jlaustill/ovgt/docs/holset/hx35/compressor-housings.md

# HX35 / H1C Compressor Housings — Part Number Reference

**Scope:** every genuine Holset part number catalogued as a *compressor housing* for the
**H1C / WH1C / HX35 / HX35W / HX35G** family. Compiled 2026-09-12.

Method, sourcing tiers and the `H`-suffix authenticity rule are identical to
[`turbine-housings.md`](turbine-housings.md) — read that first. Source data is the
archived cross-reference at [`../jhdiesel-full-catalog.tsv`](../jhdiesel-full-catalog.tsv).

## ⭐ The wastegate-tab rule (answers the current requirement)

**The wheel generation determines where the wastegate canister mounts** — and therefore
whether the compressor cover carries actuator tabs at all:

| Generation | Compressor wheel | Application | Wastegate canister mounts on | Cover has tabs? |
|---|---|---|---|---|
| **8-blade** | **56 / 82–83 mm** | '95–98 12v (manual) | **the TURBINE housing** | ✅ **NO TABS** |
| **7-blade** | **54 / 77–78 mm** | '99–02 24v (manual) | **the COMPRESSOR housing** | ❌ has tabs |

> *"You can normally tell them apart because the wastegate canister is mounted on the
> turbine housing, whereas the 7-blade's wastegate canister mounts on the compressor
> housing."* · *"When selecting a donor turbo for a turbine housing, make sure the
> actuator does not attach to the compressor cover."*

**So the tab-free cover you want is the 8-blade / 56 mm one** — the '95–98 12v generation.
This also explains the original problem: the core on hand, **`3592766`, is the 7-blade
54 mm** (`docs/holset-turbos.md:416`), i.e. the generation whose gate is *designed* to bolt
to the compressor cover. The spring gate fouling the cover is a generational mismatch, not
a defect — the same root cause as the turbine-housing clearance issue.

⚠️ **The wheel and cover must change together.** 7-blade is 54×78, 8-blade is 56×83;
they are **not interchangeable between each other's housings**. A 56 mm cover requires the
56 mm 8-blade wheel. The on-hand core's 54 mm wheel will not run in it.

⚠️ **Flow figures conflict — do not plan on them yet.** One forum source claims the
8-blade flows **52 lb/min** and the 7-blade **60 lb/min**, i.e. the *larger* wheel flowing
*less*. That is backwards on its face and contradicts `docs/holset-turbos.md:40–41`
(8-blade 56/82, 7-blade 54/76.5). Against the ~45–50 lb/min target this matters, so treat
both numbers as unverified until a compressor map is found.

**Aftermarket alternative:** matched housing + wheel sets exist and sidestep the whole
question — Gillett `CH-10` (60 mm 7-blade upgrade housing **and** wheel), and the Fenley
60 mm billet + matched cover already noted at `docs/holset-turbos.md:97`. Buying the pair
guarantees the contour matches the wheel.

## ✅ DECISION 2026-09-12: keep the 54 mm wheel, cut the tabs off the existing cover

**Staying on the 7-blade 54×78 compressor already on the core (`3592766`). The wastegate
tabs get cut off that cover rather than buying a tab-free 56 mm cover and wheel.**

Rationale: the 54 mm is close enough to generate a real operating dataset, and the truck
already carries 10 Hz CE / BPR / boost telemetry. The 52 vs 60 lb/min conflict below cannot
be settled from the available sources — but it *can* be settled from logged map coverage
against the ~45–50 lb/min target. Spending ~$160 first would be buying on numbers this
document already flags as untrustworthy. Consistent with the *"stock-spec baseline, then
iterate"* test plan in `docs/holset-turbos.md`.

**This closes the 56 mm question for now.** It is deferred, not abandoned — the swap is a
cover-and-wheel pair whenever data justifies it, and a cut-up 54 mm cover costs nothing to
walk away from at that point.

### Cutting the tabs — cautions

1. **Confirm what is actually fouling first.** The complaint was the spring gate "running
   into the compressor cover." If it contacts the **tabs**, cutting fixes it; if it contacts
   the **scroll body**, cutting achieves nothing. Mock it up and mark the contact point
   before cutting.
2. **Wall thickness is the one real hazard.** The boss may blend into the scroll wall rather
   than stand proud of it. Cutting through breaches the pressure boundary — a boost leak on
   the HP stage, which would then get chased as a phantom fault. **Probe the thickness
   first; leave the stubs proud rather than flush if unsure.** Flush is cosmetic, intact is
   functional.
3. **Cover off the turbo, cut on the bench, wash out completely.** Aluminium swarf into the
   compressor wheel ends the wheel.
4. Cast aluminium — cutoff wheel, die grinder or bandsaw all work. Irreversible, but this
   is the common cover and replacements are cheap.

### Still open regardless of this decision

Cutting tabs does **not** substitute for the turbine housing. A 12 cm² divided housing with
a **turbine-side** gate is still required — `3532214` (~$599) or the `3591217` casting
(~$120). See [`turbine-housings.md`](turbine-housings.md).

## Sourcing a 56 mm cover + wheel (surveyed 2026-09-12)

> ℹ️ Superseded by the decision above; retained because it documents the tab-free options
> and their verification, which matter again if the 56 mm swap is revisited.

The on-hand core is 7-blade 54 mm, so **both the wheel and the cover must be bought** —
they are not separable decisions. Prices are a snapshot; eBay listings move.

| Option | Price | What it gets | Notes |
|---|---|---|---|
| **Wheel only** | **$45–50** | 56×83 8-blade factory wheel, balanced | Seller *jackassturbo* states it plainly: *"Fits 1996–1998 Dodge Ram 5.9 Cummins HX35… **Does not fit** factory HX35 turbo on 1999–2002 manual"* — independent confirmation of the generation rule above. Still needs a tab-free cover |
| **Cover + wheel** ⭐ | **$159.99** | Compressor housing **and** 56 mm 8-blade wheel | *"Compressor housing with 4" inlet and vband discharge flange for HX35/40 bearing housings and includes 8 blade cast aluminum 56mm inducer compressor wheel."* Fort Collins, CO. **Tab-free — visually confirmed** (see below) |
| ❌ **Complete '96–98 turbo** | ~$312–331 | **Does NOT deliver a tab-free cover** | See the correction below — photos show a **compressor-mounted** actuator bracket despite the '96–98 listing title |
| ❌ "Supercore" listings | $199–249 | — | The ones found are **52 mm**, not 56 mm. Wrong wheel. Do not buy on the word "supercore" alone |

### ❌ Correction: the ~$312 complete turbo does not solve the tab problem

Initially flagged as the value play on the reasoning that a '96–98 unit would carry the
turbine-side gate. **Photos of the actual listing show otherwise**
([ebay.com/itm/357345678203](https://www.ebay.com/itm/357345678203), $312.25, seller
`yikaparts`, ships from CN; cites PNs `3539373` / `3538881`, both genuine
`TURBOCHARGER,HX35 WASTEGA` entries in the catalog):

The wastegate canister is carried on a **long diagonal bracket bolted to the compressor
housing**, with the rod running down to the wastegate arm on the turbine housing. That is
the compressor-cover-mounted arrangement — precisely what this requirement exists to avoid.
The T3 inlet gasket in the photos *is* correctly divided, but the actuator mounting is wrong
for this build.

⚠️ **Generalise from this:** the 8-blade → turbine-mounted-canister rule describes
**genuine Holset** production. An aftermarket reproduction can mix configurations regardless
of the model years in its title, and stock photos may not depict the item shipped. **The
generation rule does not transfer to repro units** — for those, only a photo of the actual
part settles it.

### ✅ Tab-free confirmed by photo, not by marketing copy

Listing photos of the $159.99 cover were downloaded and inspected directly. **The housing
carries no wastegate actuator tabs, bosses or drilled ears anywhere on the scroll or the
outer face.** Both faces are visible across the photo set. This is the first item in this
whole reference confirmed by an actual image rather than seller text.

Also visible: a **V-band discharge flange**, a large **4" inlet**, and a cast/machined data
pad reading `P/N:4761339  S/N:1161530182212`.

⚠️ **`4761339` is not a Holset number.** It is absent from the cross-reference, and more
tellingly the catalog contains **no `476xxxx` prefix at all** (its prefixes run 28, 30–32,
35–40, 43, 48–49, 52–53). Unlike `3591217`, which sat inside a dense Holset block, this
number falls outside the numbering space entirely — so this is an **aftermarket housing**.
For this purpose that is not a defect: aftermarket performance covers are *why* it has no
tabs. But it is not a genuine Holset casting and should not be recorded as one.

⚠️ **Two things to check before buying this specific item:**
1. **Blade count.** The listing says 8-blade; the wheel in the photo appears to show more
   than eight. The top-down angle and shadows make it unreliable to count — ask the seller
   for a straight-on shot and count them.
2. **Casting damage.** A close-up of the bearing-housing register shows a **gouge / chipped
   area on the machined outer step**. It may be cosmetic, but that face locates and seals
   against the bearing housing. Ask about it.

⚠️ **Plumbing changes.** A 4" inlet and V-band discharge is not the stock arrangement. In
the compound layout the HP compressor inlet is fed by the S472 LP discharge, so a large
inlet is not itself a problem — but the connections will need to be made to suit.

## Part numbers

`?` means *not yet sourced*, never *not applicable*. Per-PN compressor-housing specs are as
absent from the public web as the turbine-housing ones — the catalog gives model attribution
only, and vendors list these as bare "GENUINE HOLSET COMPRESSOR HOUSING" with no wheel size
or tab information.

| PN | Model | Inducer | Exducer | WG tabs | Inlet | Outlet | Verified | raw_notes |
|---|---|---|---|---|---|---|---|---|
| 3532465 | HX35 | ? | ? | ? | ? | ? | catalog only | `HOUSING,COMPRESSOR,HX35` |
| 3532467 | HX35 | ? | ? | ? | ? | ? | catalog only | `HOUSING,COMPRESSOR,HX35` |
| 3536495 | HX35 | ? | ? | ? | ? | ? | catalog only | `HOUSING,COMPRESSOR,HX35` |
| 3536502 | HX35 | ? | ? | ? | ? | ? | catalog only | `HOUSING,COMPRESSOR,HX35` |
| 3537726 | HX35 | ? | ? | ? | ? | ? | catalog only | `HOUSING,COMPRESSOR,HX35` |
| 3537732 | HX35 | ? | ? | ? | ? | ? | catalog only | `HOUSING,COMPRESSOR,HX35` |
| 3538769 | HX35 | ? | ? | ? | ? | ? | catalog only | `HOUSING,COMPRESSOR.HX35` |
| 3590646 | HX35W | ? | ? | ? | ? | ? | catalog only | `HOUSING,COMPRESSOR.HX35W.ASSY` |
| 3591005 | HX35W | ? | ? | ? | ? | ? | catalog only | `HOUSING,COMPRESSOR,HX35W,ASSY` |
| 3591006 | HX35W | ? | ? | ? | ? | ? | catalog only | `HOUSING,COMPRESSOR.HX35W.ASSY` |
| 3591008 | HX35W | ? | ? | ? | ? | ? | catalog only | `HOUSING,COMPRESSOR.HX35W.ASSY` |
| 3591012 | HX35G | ? | ? | ? | ? | ? | catalog only ⚠️ | `HOUSING,COMPRESSOR.HX35G.ASSY`. ⚠️ **Gas/CNG variant** — `G` is the natural-gas application (catalog lists `TURBOCHARGER,HX35GAS`); water-cooled, billet 7-blade. Wheel family not established for the diesel build |
| 3591014 | HX35W | ? | ? | ? | ? | ? | catalog only | `HOUSING,COMPRESSOR.HX35W.ASSY` |
| 3592355 | HX35 | ? | ? | ? | ? | ? | catalog only | `HOUSING,COMPRESSOR.HX35` |
| 3595195 | HX35 | ? | ? | ? | ? | ? | catalog only | `HOUSING,COMPRESSOR,HX35` |
| 3595896 | HX35 | ? | ? | ? | ? | ? | catalog only | `HOUSING,COMPRESSOR,HX35` |
| 3596776 | HX35W | ? | ? | ? | ? | ? | catalog only | `HOUSING,COMPRESSOR,HX35W,ASSY` |
| 3597306 | HX35 | ? | ? | ? | ? | ? | catalog only | `HOUSING,COMPRESSOR,HX35` |
| 3598643 | HX35 | ? | ? | ? | ? | ? | catalog only | `HOUSING,COMPRESSOR,HX35,ASSY` |
| 3599319 | HX35W | ? | ? | ? | ? | ? | catalog only | `HOUSING,COMPRESSOR,HX35W,ASSY` |
| 3599984 | HX35 | ? | ? | ? | ? | ? | catalog only | `HOUSING,COMPRESSOR,HX35` |
| 4036101 | HX35W | ? | ? | ? | ? | ? | catalog only | `HOUSING,COMPRESSOR,HX35W,ASSY` |
| 4036492 | HX35 | ? | ? | ? | ? | ? | catalog only | `HOUSING,COMPRESSOR,HX35` |
| 4036745 | HX35W | ? | ? | ? | ? | ? | catalog only | `HOUSING,COMPRESSOR,HX35W,ASSY` |
| 4037109 | HX35 | ? | ? | ? | ? | ? | catalog only | `HOUSING,COMPRESSOR,HX35` |
| 4037836 | HX35 | ? | ? | ? | ? | ? | catalog only | `HOUSING,COMPRESSOR.HX35` |
| 4038469 | HX35W | ? | ? | ? | ? | ? | **vendor-listed** | `HOUSING,COMPRESSOR,HX35W,ASSY`. Denco: *"BRAND NEW GENUINE HOLSET COMPRESSOR HOUSING"*, HX35, 5.0 kg, A$356.36. No wheel size or tab detail given |
| 4040185 | HX35W | ? | ? | ? | ? | ? | catalog only | `HOUSING,COMPRESSOR,HX35W,ASSY` |
| 4044030 | HX35 | ? | ? | ? | ? | ? | catalog only | `HOUSING,COMPRESSOR.HX35` |

## Caveats

**The catalog is not exhaustive** — same as the turbine-housing list. `3591005`/`3591006`/
`3591008`/`3591014` are all `HOUSING,COMPRESSOR.HX35W.ASSY` with no way to tell them apart
from the catalog alone, and the bare-casting vs `.ASSY` distinction (housing alone vs
housing + fitted hardware) is unresolved here exactly as it is there.

**Tabs are the thing to verify, and no vendor states it.** Not one listing found mentions
actuator bracket bosses either way. Until a vendor or a measured photo confirms it, the
only reliable signal is the **generation** (8-blade '95–98 = no tabs) rather than the part
number. Ask for a photo of the cover's outer face.

## Sources

- Archived cross-reference: [`../jhdiesel-full-catalog.tsv`](../jhdiesel-full-catalog.tsv)
- [Mopar1973Man — Holset turbo specs](https://mopar1973man.com/cummins/articles.html/general-cummins/84_engine/89_air-exhaust/holset-turbo-specs-r156/) — blade count / canister location rule
- [Denco — 4038469 compressor housing](https://www.dencodiesel.com/products/4038469-holset-compressor-housing-hx35)
- [Gillett — CH-10 60 mm 7-blade upgrade housing + wheel](https://www.gillettdiesel.com/shop/Holset-HX-Upgrade-Compressor-Housing--and--Wheel-60mm--7-blade-CH-10)
- Sibling docs: [`turbine-housings.md`](turbine-housings.md) · [`chra-cores.md`](chra-cores.md) · parent `docs/holset-turbos.md`
