jlaustill/ovgt/src/sensors/j1939.cpp

#include <Arduino.h>
#include <FlexCAN_T4.h>
#include "j1939.h"
#include "AppData.h"
#include "j1939Decode.h"
#include "j1939Health.h"
#include "j1939Encode.h"
#include "systemHealth.h"
#include <J1939McuHealth.h>
#include "mcuHealthFrame.h"

// CAN2 = Teensy 4.1 pins 0 (RX) / 1 (TX). J1939 @ 250 kbps, 29-bit extended IDs.
static FlexCAN_T4<CAN2, RX_SIZE_256, TX_SIZE_16> Can1939;

static const uint8_t  SA              = 0x01;
static const uint32_t PGN_AMB         = 65270; // AMB — SPN 102 (byte 2, boost), SPN 173 (bytes 6-7, EGT)
static const uint32_t PGN_OIL_TEMP    = 65262; // SPN 175 (bytes 3-4) + SPN 176 (bytes 5-6) — Engine Oil Temperature
static const uint32_t PGN_FLUID_PRESS = 65263; // SPN 94 (byte 1) fuel, SPN 100 (byte 4) oil pressure
static const uint32_t PGN_EEC2 = 61443; // EEC2 — SPN 91 throttle, SPN 92 load
static const uint32_t PGN_ETC1 = 61442; // ETC1 — SPN 573 TCC lockup, 191/161/522

// J1939 RX-decode targets (received from engine/trans; distinct from OVGT's own TX).
static const uint32_t PGN_EEC1     = 61444;
static const uint32_t PGN_IC1      = 65270; // engine SA 0x00 (distinct from OVGT's own TX)
static const uint32_t PGN_AMB65269 = 65269;
static const uint32_t PGN_VEP1     = 65271;
static const uint32_t PGN_ET1      = 65262;
static const uint32_t PGN_EFLP1    = 65263;
static const uint32_t PGN_ETC2     = 61445;

static const uint8_t SA_ENGINE = 0x00;
static const uint8_t SA_TRANS  = 0x03;

// Unknown-PGN discovery inventory (ISR-updated, main-loop-read).
struct UnknownPgn {
    uint32_t pgn;
    uint8_t  sa;
    uint32_t count;
    uint32_t firstMs;
    uint32_t lastMs;
    uint8_t  last[8];
};
static const uint8_t UNKNOWN_MAX = 32;
static volatile UnknownPgn unknownTable[UNKNOWN_MAX];
static volatile uint8_t unknownUsed = 0;
static volatile uint32_t unknownDropped = 0;

static void tallyUnknown(uint32_t pgn, uint8_t sa, const uint8_t *buf, uint32_t now) {
    for (uint8_t i = 0; i < unknownUsed; i++) {
        if (unknownTable[i].pgn == pgn && unknownTable[i].sa == sa) {
            unknownTable[i].count++;
            unknownTable[i].lastMs = now;
            for (uint8_t b = 0; b < 8; b++) unknownTable[i].last[b] = buf[b];
            return;
        }
    }
    if (unknownUsed >= UNKNOWN_MAX) { unknownDropped++; return; }
    uint8_t i = unknownUsed++;
    unknownTable[i].pgn = pgn; unknownTable[i].sa = sa;
    unknownTable[i].count = 1; unknownTable[i].firstMs = now; unknownTable[i].lastMs = now;
    for (uint8_t b = 0; b < 8; b++) unknownTable[i].last[b] = buf[b];
}

// Standard turbo/intake PGNs (each carries our signal in bytes 1-2, turbo 2-4
// siblings left 0xFF = not available). See docs/j1939-spn-mapping.md.
static const uint32_t PGN_ENGINE_INFO     = 65170; // SPN 1209 exhaust gas (turbine inlet) pressure, bytes 2-3
static const uint32_t PGN_INTAKE_MANIFOLD = 65190; // SPN 1127 turbo 1 boost pressure, bytes 1-2
static const uint32_t PGN_TURBO_INFO_2    = 65178; // SPN 1172 compressor intake temp, bytes 1-2
static const uint32_t PGN_TURBO_INFO_3    = 65177; // SPN 1176 compressor intake pressure, bytes 1-2
static const uint32_t PGN_TURBO_INFO_4    = 65176; // SPN 1180 turbine intake temp, bytes 1-2
static const uint32_t PGN_TURBO_INFO_6    = 64979; // SPN 2629 compressor outlet temp, bytes 1-2

static uint32_t lastTx100ms = 0;
static uint32_t lastTx500ms = 0;
static uint32_t lastTx1000ms = 0;

// Write a 2-byte little-endian J1939 field at buf[pos] (0-based).
static void put16(uint8_t *buf, uint8_t pos, uint16_t value) {
    buf[pos] = value & 0xFF;
    buf[pos + 1] = value >> 8;
}

static void j1939Sniff(const CAN_message_t &msg) {
    uint32_t pgn = pgnFromCanId(msg.id);
    uint8_t  sa  = saFromCanId(msg.id);
    uint32_t now = millis();

    if (sa == SA_ENGINE) {
        switch (pgn) {
            case PGN_EEC1:
                appData.engineRpm = decodeEngineRpm(msg.buf);
                appData.engineRpmRaw = j1939RawStatus2Byte((uint16_t)msg.buf[3] | ((uint16_t)msg.buf[4] << 8));
                appData.driverDemandTorquePct = decodeDriverDemandTorquePct(msg.buf);
                appData.actualTorquePct = decodeActualTorquePct(msg.buf);
                appData.torqueRaw = j1939RawStatus1Byte(msg.buf[2]);
                appData.lastEec1RxMs = now;
                if (appData.engineOnlineAtMs == 0) appData.engineOnlineAtMs = now;
                return;
            case PGN_EEC2:
                appData.acceleratorPedalPercent = decodeAcceleratorPedalPercent(msg.buf);
                appData.engineLoadPercent = decodeEngineLoadPercent(msg.buf);
                appData.lastEec2RxMs = now;
                if (appData.engineOnlineAtMs == 0) appData.engineOnlineAtMs = now;
                return;
            case PGN_IC1:
                appData.intakeAirTempC = decodeIntakeAirTempC(msg.buf);
                appData.intakeAirRaw = j1939RawStatus1Byte(msg.buf[2]);
                appData.j1939BoostKpa = decodeBoostKpa(msg.buf);
                appData.boostRaw = j1939RawStatus1Byte(msg.buf[1]);
                appData.lastIc1RxMs = now;
                return;
            case PGN_AMB65269:
                appData.preTurboKpa = decodePreTurboKpa(msg.buf);
                appData.preTurboRaw = j1939RawStatus1Byte(msg.buf[0]);
                appData.lastAmbRxMs = now;
                return;
            case PGN_VEP1:
                appData.systemVoltage = decodeSystemVoltage(msg.buf);
                appData.systemVoltageRaw = j1939RawStatus2Byte((uint16_t)msg.buf[4] | ((uint16_t)msg.buf[5] << 8));
                appData.lastVep1RxMs = now;
                return;
            case PGN_ET1:
                appData.coolantTempC = decodeCoolantTempC(msg.buf);
                appData.coolantRaw = j1939RawStatus1Byte(msg.buf[0]);
                appData.engineOilTempC = decodeOilTempC(msg.buf);
                appData.oilTempRaw = j1939RawStatus2Byte((uint16_t)msg.buf[2] | ((uint16_t)msg.buf[3] << 8));
                appData.lastEt1RxMs = now;
                return;
            case PGN_EFLP1:
                appData.oilPressureKpaJ1939 = decodeOilPressureKpa(msg.buf);
                appData.oilPressRaw = j1939RawStatus1Byte(msg.buf[3]);
                appData.lastEflRxMs = now;
                return;
        }
    } else if (sa == SA_TRANS) {
        switch (pgn) {
            case PGN_ETC1:
                appData.torqueConverterLockupStatus = decodeTorqueConverterLockup(msg.buf);
                appData.outputShaftRpm = decodeOutputShaftRpm(msg.buf);
                appData.outputShaftRaw = j1939RawStatus2Byte((uint16_t)msg.buf[1] | ((uint16_t)msg.buf[2] << 8));
                appData.inputShaftRpm = decodeInputShaftRpm(msg.buf);
                appData.inputShaftRaw = j1939RawStatus2Byte((uint16_t)msg.buf[5] | ((uint16_t)msg.buf[6] << 8));
                appData.clutchSlipPct = decodeClutchSlipPct(msg.buf);
                appData.clutchSlipRaw = j1939RawStatus1Byte(msg.buf[3]);
                appData.lastEtc1RxMs = now;
                if (appData.transOnlineAtMs == 0) appData.transOnlineAtMs = now;
                return;
            case PGN_ETC2:
                appData.selectedGear = decodeSelectedGear(msg.buf);
                appData.selectedGearRaw = j1939RawStatus1Byte(msg.buf[0]);
                appData.currentGear = decodeCurrentGear(msg.buf);
                appData.currentGearRaw = j1939RawStatus1Byte(msg.buf[3]);
                appData.gearRatioMilli = decodeGearRatioMilli(msg.buf);
                appData.gearRatioRaw = j1939RawStatus2Byte((uint16_t)msg.buf[1] | ((uint16_t)msg.buf[2] << 8));
                appData.lastEtc2RxMs = now;
                if (appData.transOnlineAtMs == 0) appData.transOnlineAtMs = now;
                return;
        }
    }
    // Undecoded frame from any SA (skip our own SA 0x01 transmissions).
    if (sa != SA) tallyUnknown(pgn, sa, msg.buf, now);
}

void J1939::Initialize() {
    Can1939.begin();
    Can1939.setBaudRate(250 * 1000);
    Can1939.setMaxMB(16);
    // Non-FIFO default: MB0-7 RX_EMPTY, MB8-15 TX_INACTIVE
    Can1939.enableMBInterrupts();   // RX full + TX done interrupts on all MBs
    Can1939.onReceive(j1939Sniff);
    Serial.println("J1939 (CAN2 @ 250kbps) initialized");
}

static void sendPgn(uint32_t pgn, const uint8_t* data) {
    CAN_message_t msg;
    msg.flags.extended = 1;
    msg.id = (6UL << 26) | (pgn << 8) | SA;
    msg.len = 8;
    memcpy(msg.buf, data, 8);
    Can1939.write(msg);
}

static void transmit100ms() {
    uint8_t buf[8];

    // AMB — PGN 65270
    // SPN 102 (byte 2): intake manifold pressure, 2 kPa/bit
    // SPN 173 (bytes 6-7): EGT, 0.03125 deg C/bit, offset -273
    memset(buf, 0xFF, 8);
    buf[1] = (uint8_t)((appData.compressorOutputPressureHpaa - appData.compressorInputPressureHpaa) / 10 / 2);
    uint16_t egtRaw = (uint16_t)((appData.turbineInletTempC + 273) * 32);
    buf[5] = egtRaw & 0xFF;
    buf[6] = egtRaw >> 8;
    sendPgn(PGN_AMB, buf);

    // Oil Temp — PGN 65262
    // SPN 175 (bytes 3-4): Engine Oil Temp 1, 0.03125 deg C/bit, offset -273
    // SPN 176 (bytes 5-6): Turbocharger Oil Temp, same encoding
    memset(buf, 0xFF, 8);
    uint16_t oilTmpRaw = (uint16_t)((appData.oilTempC + 273) * 32);
    buf[2] = oilTmpRaw & 0xFF;
    buf[3] = oilTmpRaw >> 8;
    buf[4] = oilTmpRaw & 0xFF;
    buf[5] = oilTmpRaw >> 8;
    sendPgn(PGN_OIL_TEMP, buf);

    // Engine Information — PGN 65170 (standard rate 100 ms)
    // SPN 1209 (bytes 2-3): exhaust gas / turbine inlet (drive) pressure
    memset(buf, 0xFF, 8);
    put16(buf, 1, j1939EncodeTurboPressureRaw((float)appData.turbineInputPressureHpa));
    sendPgn(PGN_ENGINE_INFO, buf);
}

static void transmit500ms() {
    uint8_t buf[8];

    // Fluid pressures — PGN 65263
    // SPN 94 (byte 1): fuel delivery pressure, 4 kPa/bit
    // SPN 100 (byte 4): engine oil pressure, 4 kPa/bit
    memset(buf, 0xFF, 8);
    buf[0] = (uint8_t)(appData.liftPumpPressureHpa / 10 / 4);
    buf[3] = (uint8_t)(appData.oilPressureHpa / 10 / 4);
    sendPgn(PGN_FLUID_PRESS, buf);

    // Intake Manifold Information 1 — PGN 65190 (standard rate 500 ms)
    // SPN 1127 (bytes 1-2): turbo 1 boost pressure, 0.125 kPa/bit
    memset(buf, 0xFF, 8);
    float boostHpa = (float)appData.compressorOutputPressureHpaa
                   - (float)appData.compressorInputPressureHpaa;
    put16(buf, 0, j1939EncodeBoostRaw(boostHpa));
    sendPgn(PGN_INTAKE_MANIFOLD, buf);
}

static void transmit1000ms() {
    uint8_t buf[8];

    // Turbocharger Information 4 — PGN 65176: SPN 1180 turbine intake temp
    memset(buf, 0xFF, 8);
    put16(buf, 0, j1939EncodeTemperatureRaw((float)appData.turbineInletTempC));
    sendPgn(PGN_TURBO_INFO_4, buf);

    // Turbocharger Information 2 — PGN 65178: SPN 1172 compressor intake temp (CIT)
    memset(buf, 0xFF, 8);
    put16(buf, 0, j1939EncodeTemperatureRaw((float)appData.compressorInputTempC));
    sendPgn(PGN_TURBO_INFO_2, buf);

    // Turbocharger Information 6 — PGN 64979: SPN 2629 compressor outlet temp (COT)
    memset(buf, 0xFF, 8);
    put16(buf, 0, j1939EncodeTemperatureRaw((float)appData.compressorOutputTempC));
    sendPgn(PGN_TURBO_INFO_6, buf);

    // Turbocharger Information 3 — PGN 65177: SPN 1176 compressor intake pressure (CIP)
    memset(buf, 0xFF, 8);
    put16(buf, 0, j1939EncodeTurboPressureRaw((float)appData.compressorInputPressureHpaa));
    sendPgn(PGN_TURBO_INFO_3, buf);

    // MCU health — PGN 0xFFDC (Proprietary B, broadcast). Controller die temp +
    // reset cause + boot count + uptime, so a listener collects one record per MCU
    // by source address. Payload encoding lives in jlaustill/J1939 (McuHealth).
    McuHealth health = buildMcuHealth(tempmonGetTemp(),
                                      SystemHealth_resetCauseCode(),
                                      SystemHealth_bootCount(),
                                      millis() / 60000UL);
    uint8_t healthBuf[8];
    J1939McuHealth_encode(&health, healthBuf);
    sendPgn(J1939McuHealth_PGN, healthBuf);
}

uint8_t J1939::unknownCount() { return unknownUsed; }
uint32_t J1939::unknownDroppedCount() { return unknownDropped; }

bool J1939::unknownAt(uint8_t i, uint32_t &pgn, uint8_t &sa, uint32_t &count,
                      uint32_t &firstMs, uint32_t &lastMs, uint8_t out8[8]) {
    if (i >= unknownUsed) return false;
    noInterrupts();
    pgn = unknownTable[i].pgn; sa = unknownTable[i].sa; count = unknownTable[i].count;
    firstMs = unknownTable[i].firstMs; lastMs = unknownTable[i].lastMs;
    for (uint8_t b = 0; b < 8; b++) out8[b] = unknownTable[i].last[b];
    interrupts();
    return true;
}

void J1939::Loop() {
    Can1939.events();
    uint32_t now = millis();
    if (now - lastTx100ms >= 100) {
        lastTx100ms = now;
        transmit100ms();
    }
    if (now - lastTx500ms >= 500) {
        lastTx500ms = now;
        transmit500ms();
    }
    if (now - lastTx1000ms >= 1000) {
        lastTx1000ms = now;
        transmit1000ms();
    }
}
