jlaustill/ovgt/(commit log)

2025-01-28 initial actuator code
2025-05-23 encapsulate lcd code and use a timer instead of millis
2025-05-23 Add README with hardware documentation and refactor actuator pin to be configurable
2025-05-23 Update README: Mark LCD as optional and correct CAN bus description
2025-06-02 Update README.md
    Adjust pins for I2C usage
2026-03-03 Remove ADS7606, MicroMod Teensy, and thermocouple references
    Simplify hardware scope to current build: Teensy 4.1, 2x CAN
    transceivers, FRAM, TIP120, and optional LCD. Removes unused
    Adafruit_BusIO and Adafruit_ADS1X15 dependencies.
2026-03-03 Add boost control loop design document
    Documents the architecture for ADS1115 sensor integration with
    closed-loop VGT vane control via pressure-to-position lookup table.
2026-03-03 Add BoostSensor module for ADS1115 pressure reading
2026-03-03 Add BoostController with tunable pressure-to-position lookup table
2026-03-03 Implement interpolation logic for pressure-to-position lookup table
2026-03-03 Simplify Actuator to read demanded position from AppData
2026-03-03 Wire BoostSensor and BoostController into main loop
2026-03-03 Update LCD to display boost pressure
2026-03-03 Move actuator CAN to CAN3 (pins 30/31) due to bad CAN2 transceiver
    Swapped actuator and J1939 CAN bus assignments. CAN2 transceiver
    (pins 0/1) is faulty — actuator now uses CAN3 on the working
    transceiver. README updated to match.
2026-03-03 Add actuator calibration sweep and raw position tracking
    - Add rawPosition field to AppData for unprocessed CAN feedback
    - Invert reported position mapping (vanes open = higher %)
    - Add CalibrateLoop() that sweeps PWM 0-255 logging CSV data
    - Remove per-message CAN serial spam, consolidate to 1s summary
    - Improve debug output with all telemetry on one line
    [AppData.h, ovgt.cpp]
2026-03-03 Add manual PWM control, vane calibration mapping, and 5V power good safety
    - Add serial command interface: type 0-247 for manual PWM, 'auto' for normal
    - Fix SetPosition to use correct vane calibration (PWM 7-201)
    - Add SetPWM method for direct actuator control during calibration
    - Read 5V PSU power good on pin 33: if PG fails, force vanes to 95% open
    - Update debug output with PG status and demanded position
    [ovgt.cpp, ovgt.h]
2026-03-04 Show raw actuator position, fix PG logic, tune lookup table
    - Remove fake reported position percentage, show raw CAN value instead
    - Fix PG pin read logic for active-low signal
    - Update first lookup table entry to 20% at 1000 hPa
    [ovgt.cpp]
2026-03-06 Add multi-channel ADS1115 round-robin and make appData a global
    Replace single-channel BoostSensor with AdcSensors that reads 4 channels
    (boost pressure, compressor input pressure, compressor input temp,
    turbine input pressure) via non-blocking single-shot conversions with
    DRDY interrupt. Make appData a global extern instead of passing pointers
    through every class.
    [AppData.h, adcSensors.cpp, adcSensors.h, ovgt.cpp, ovgt.h]
2026-03-14 Fix manual vane control and move debug output out of ISR
    - Move heavy debug work (I2C LCD + Serial prints) from IntervalTimer ISR
    to main loop via flag, fixing serial input being dropped
    - Manual mode now sets vane position (0-100%) instead of raw PWM
    - Keep sensors updating in manual mode so readings stay live
    - Add gauge boost, ambient pressure tracking, and boost ratio to debug output
    - Update boost controller to use gauge boost instead of absolute pressure
    [AppData.h, adcSensors.cpp, ovgt.cpp, ovgt.h]
2026-04-03 Switch to CAN actuator control, PSI lookup table, and simplified debug
    Replace LCD display with CAN-based vane position commands (0x4EA/0x4EB),
    convert boost lookup table from hPa to PSI to match dashboard display,
    and streamline serial debug to four key fields for road tuning.
    - CAN actuator: 20ms IntervalTimer, position mapping 0-250, feedback 0-1000
    - PSI lookup table with float interpolation (0→30%, 2→40%, 7.3→50%, 53.5→68%)
    - Correct TIP sensor to 100 PSIG (was 150), update scaling factor
    - Add DWT cycle counting and 10ms loop rate limiting
    - Remove LiquidCrystal_I2C dependency and lcdDisplay files
    - Include pid_bench.cpp for standalone PID testing (excluded from build)
    Co-Aut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
    [AppData.h, adcSensors.cpp, ovgt.cpp, ovgt.h, pid_bench.cpp]
2026-04-04 Add 860 SPS EMA filtering, TIP zero calibration, and dedicated ADC timer
    Bump ADS1115 to 860 SPS with exponential moving average (alpha=0.01) to
    eliminate sensor noise that caused false boost/BPR readings at rest.
    Add per-session TIP zero voltage calibration with runtime floor tracking
    to handle sensor tolerance below the nominal 0.5V zero point. Decouple
    ADC sampling from the 10ms control loop onto its own 1.2ms timer.
    [AppData.h, adcSensors.cpp, adcSensors.h, ovgt.cpp]
2026-04-29 Add MAX31856 thermocouple sensors, update pin assignments, and document hardware
    - Add COT, CIT, TIT, TOT sensor drivers (MAX31856 #1-4)
    - Update titSensor to new pin assignment (CS=5, DRDY=3, FLT=4)
    - Add compressorOutputTempC and turbineOutletTempC to AppData
    - Document all sensor channels and pin assignments in README
    - Fix FRAM CS pin (32→10) and add FRAM HOLD/WP pins
    - Add second ADS1115 (0x49) pin and channel documentation
    - Update boost controller pressure map
    [AppData.h, citSensor.cpp, j1939.cpp, j1939.h, ovgt.cpp]
2026-04-29 Add FRAM support and fix SPI bus CS pin initialization
    - Add Adafruit FRAM SPI library and fram.cpp/h driver
    - Drive all SPI CS pins HIGH at startup to prevent bus contention
    - This fixed FRAM write failures caused by floating MAX31856 CS pins
    [fram.cpp, ovgt.cpp]
2026-04-30 Add J1939 TX for EGT/oil temp/fuel pressure and enable boost controller
    Transmits SPN 173 (EGT), SPN 175 (oil temp), and SPN 94 (fuel delivery
    pressure) at 10 Hz over CAN2 using non-FIFO FlexCAN_T4 mailbox mode.
    Re-enables AdcSensors and BoostController which were disabled during
    J1939 bring-up. Removes serial logging noise from J1939 and ADC paths.
    [AppData.h, adcSensors.cpp, j1939.cpp, ovgt.cpp]
2026-05-01 Add ADS1115 #2 (0x49) for oil temp, oil pressure, and lift pump pressure
    Wires up the second ADS1115 with a full 4-channel ISR-driven round-robin
    matching ADS1 — TOP (AIN0), oil pressure (AIN1), oil temp (AIN2, GM NTC),
    lift pump pressure (AIN3). Adds oilPressureHpa and turbineOutPressureHpa
    to AppData. Updates J1939 TX to include SPN 100 (oil pressure, byte 3 of
    PGN 65263) and SPN 176 (turbocharger oil temp, bytes 4-5 of PGN 65262).
2026-05-01 Fix ADS2 state machine starved by ADS1 early returns
    Both state machines are now independent if/else chains that both
    execute on every update() call. The previous early-return structure
    meant ADS2 could only advance when ADS1 completed a read, running
    at half speed and vulnerable to the 5ms timeout window.
    [adcSensors.cpp]
2026-05-01 Calibrate oil pressure (150 PSI) and oil temp (AEM 30-2013) sensors
2026-05-16 Add CIP/CIT sensors, fix S-H coefficients, use real CIP for boost gauge
    - Wire CIP (AEM 30-2130-15, 0-15 PSIa) and CIT (GM 25037225 IAT) on ADS1 A1/A2
    - Fix GM 25037225 Steinhart-Hart coefficients derived from published resistance
    table; old values had ~5°C systematic cold bias across the range
    - Replace ambientPressureGuessHpa with real CIP reading for boost gauge and
    boost controller — accurate at altitude from first sample, no convergence wait
    - Add BR (compressor pressure ratio = COP/CIP absolute) to debug output
    - Replace TIPv voltage with TIP in PSI; drop COT and TOT until sensors wired
    - Fix CIT circuit comment: pullup from 5V, not pulldown to GND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
    [AppData.h, adcSensors.cpp, ovgt.cpp]
2026-05-18 Add Deutsch DT connector pinout to README
    Documents all 4×12-pin DT connectors (A–D) with signal names, sensor
    supplies, grounds, CAN buses, thermocouple pairs, and USB wiring.
    Uncertain pins on connector A are flagged for harness verification.
2026-05-28 Fix J1939 byte offsets, add boost SPN, correct PGN naming and tx rates
    - EGT (SPN 173) was at buf[4-5] (bytes 5-6); spec requires bytes 6-7 (buf[5-6])
    - Add SPN 102 (intake manifold pressure / boost) to PGN 65270 at byte 2, 2 kPa/bit
    - Rename PGN_EGT -> PGN_AMB; use decimal PGN numbers to match codebase convention
    - Fix PGN/SPN byte annotations in comments (were 0-indexed, now match J1939 1-indexed spec)
    - Split transmit into transmit100ms (AMB, oil temp) and transmit500ms (fluid pressure)
    to match PGN 65263 spec rate of 0.5 s
    [j1939.cpp]
2026-05-28 Fix SPN 102 to use gauge pressure (COP - CIP)
    SPN 102 spec says "gage pressure" — was incorrectly sending absolute COP.
    Gauge boost = boostPressureHpa - compressorInputPressureHpa, matching
    what the boost controller already uses for the same reading.
    [j1939.cpp]
2026-05-28 Rename pressure fields to clarify absolute vs gauge semantics
    boostPressureHpa -> compressorOutputPressureHpaa (COP, absolute)
    compressorInputPressureHpa -> compressorInputPressureHpaa (CIP, absolute)
    "Boost" implies gauge pressure by definition in turbo terminology.
    The 'aa' suffix (hPaa) mirrors psia/psig convention — unambiguous at
    the call site that these are absolute readings, not gauge.
2026-06-13 Add exhaust brake v1 design spec
    VGT-based exhaust brake: when TC is locked and throttle/load are 0,
    close vanes under PI control to hold a target backpressure (default
    60 psi), with instant throttle release, a valve-float ceiling cutoff,
    and a stale-CAN failsafe. Includes J1939 RX decode for the trigger
    signals (ETC1 TC lockup, EEC2 throttle + load).
    Backpressure limits researched for the 2004 5.9L 24-valve Cummins:
    valve float is the binding constraint (~65 psi), 60 psi matches the
    PacBrake PRXB setpoint and requires 60 psi exhaust valve springs.
2026-06-13 Add exhaust brake implementation plan
    8 TDD tasks: native test env, J1939 decode helpers, brake control
    logic (state machine + PI), AppData fields, j1939Sniff wiring,
    ExhaustBrakeController glue, orchestrator integration, verification.
2026-06-13 Add exhaust brake control logic with native tests
2026-06-13 Add AppData fields for exhaust brake J1939 inputs and state
2026-06-13 Add ExhaustBrakeController Arduino glue
2026-06-13 Wire exhaust brake into orchestrator with actuator arbitration
2026-06-13 Fix inverted vane direction in exhaust brake
    On this actuator 0% = fully closed (max backpressure) and 68% = fully
    open. The original logic assumed the opposite, so the PI loop drove the
    vanes OPEN to build backpressure and the ceiling cutoff closed them
    further. Validated on-truck: brake now drives toward closed on engage
    and opens for ceiling relief.
    Renames BrakeConfig.min/maxVanePercent to vaneClosedPercent/
    vaneOpenPercent for clarity, and adds a directional regression test.
2026-06-13 Correct vane direction in design spec; note on-truck actuator finding
2026-06-13 Suppress auto controllers in manual mode
    In manual mode the boost map was overwriting actuatorDemandedPosition
    every cycle, so manually commanded vane positions never reached the
    actuator (the 20ms CAN timer kept sending the boost-map value). Gate
    both controllers behind !manualMode so the serial handler owns the
    demand while manual is active. Validated on-truck: manual commands now
    move and hold the vanes.
2026-06-14 Add actuator C-Next pilot design spec
    First module of the C-Next migration: convert actuator to actuator.cnx
    mirroring OSSM's J1939Bus.cnx (FlexCAN_T4 used natively, no shim), and
    move the CAN write out of the 20ms timer ISR via an atomic/critical SPSC
    ring buffer drained in Loop(). Addresses the leading reboot-loop suspect.
2026-06-14 Add actuator C-Next pilot implementation plan
    6 tasks: build hook + skeleton scope (validate toolchain/interop),
    FlexCAN bring-up + store-only RX, standalone CanTxQueue SPSC ring buffer
    (TDD, dependency-free for isolated testing), timer-enqueue + Loop-drain
    to move the CAN write out of ISR, full build/bench verification, and
    static-analysis before/after doc.
2026-06-14 Add CrashReport diagnostic to setup() for reboot-loop investigation
    Prints the Teensy fault report (type + program counter) on boot after a
    fault-induced reset; stays blank if resets are power/brownout.
    [ovgt.cpp]
2026-06-14 Add C-Next build pipeline + actuator skeleton scope
    cnext.config.json (cppRequired:true) -> C++ output so the actuator can
    use the FlexCAN_T4 C++ template. pre:cnext_build.py transpiles
    actuator.cnx on build. Generated actuator.cpp + include/actuator.hpp
    committed. ovgt.cpp now calls the extern "C" Actuator_Initialize()/
    Actuator_Loop(); old hand-written actuator.cpp/.h removed.
2026-06-14 Add FlexCAN bring-up and store-only RX callback in actuator.cnx
    Validates FlexCAN_T4<CAN3> template instance, C-Next ISR callback via
    onReceive, and direct C++ appData struct access from C-Next — all build
    clean for teensy41. RX decodes feedback (id 0x4EB) into appData only;
    no CAN write or work in interrupt context.
2026-06-14 Add standalone SPSC CanTxQueue scope in C-Next
    Dependency-free ring buffer of vane-position bytes (atomic head/tail,
    critical{} drain, power-of-two mask). Verified by transpilation
    inspection + on-target build, matching c-next's own approach (it
    auto-skips x86 execution of PRIMASK/atomic code). Generated code is
    correct; note the atomic indices currently lack volatile due to
    c-next#998 (scope-atomic drops volatile) -- de-facto safe here via
    function-call boundaries + critical{} barrier on single-core Cortex-M7.
2026-06-14 Move actuator CAN write out of ISR via timer-enqueue + Loop-drain
    The 20ms IntervalTimer ISR now only enqueues the demanded position into
    CanTxQueue; Loop() drains the queue and performs canBus.write() in main
    context. This removes the canBus.write()-from-ISR that was the leading
    reboot-loop suspect. IntervalTimer works natively in C-Next (no shim).
2026-06-14 Document actuator C-Next conversion: static-analysis before/after
2026-06-14 Simplify actuator: vane position is a latest-value singleton
    Remove CanTxQueue ring buffer + 20ms IntervalTimer. The demanded vane
    position is a single setpoint, so Loop() (main context, ~10ms) just sends
    appData.actuatorDemandedPosition via canBus.write() — still out of ISR,
    with zero concurrency machinery. A FIFO is for the future TCM->ECU CAN
    forwarding feature, not this singleton. Also drop unnecessary this./global.
    qualifiers (bare names resolve correctly; ADR-057).
2026-06-14 Remove unnecessary cppRequired from cnext.config.json
    C-Next auto-detects C++ output when it can parse a C++ header you include
    (FlexCAN_T4.h is found via the include paths), so cppRequired is not needed.
    The Task-1 skeleton only included <Arduino.h>, which cnext can't locate, so
    it fell back to C mode -- that was the real reason, not a missing flag.
2026-06-14 Underclock to 150MHz + show MCU temp (fix thermal-panic reboots)
    Root cause of the lockups/reboots was the i.MX RT1062 thermal panic
    (~90-95C) in the sealed engine-bay enclosure, captured by CrashReport
    ('Reboot was caused by temperature sensor', 90.84C) — not a code fault.
    The exhaust-brake feature's added CPU load (per-frame J1939 RX decode)
    tipped an already-marginal thermal situation over the edge.
    Drop F_CPU 600MHz -> 150MHz (lowest mainstream clock keeping USB/CAN/
    SPI/I2C functional) to cut heat; add tempmonGetTemp() to the 1Hz debug
    line to watch headroom live. Heatsinks on the chip for further margin.
    [ovgt.cpp]
2026-06-14 Add runtime clock (F_CPU_ACTUAL) to debug line
    So we can confirm the underclock actually applied at runtime (the
    bench held ~79C at 150MHz, higher than expected — rule out the clock
    not dropping vs. environmental/board heat).
2026-06-14 Extract vane travel limits to VaneConfig.h (single source of truth)
    Was hardcoded as 68 in exhaustBrakeController + a stale boost comment.
    Now VANE_CLOSED_PERCENT/VANE_OPEN_PERCENT live in include/VaneConfig.h,
    referenced by the exhaust brake config, the boost map comment, and a new
    actuator-side clamp that enforces the open stop at the source (no consumer
    can drive past it). Bumped the open limit 68 -> 88 after cleaning the vane
    pack freed up range of motion. C-Next reads the shared const fine.
2026-06-14 Run at 600MHz (full speed) — healthy Teensy holds ~42C steady
    The thermal panic was a failing chip, not clock-related: the new Teensy
    idles ~40C at 150MHz and ~42-43C steady at 600MHz (clock barely affects
    temp; heat is baseline/static, not CPU dynamic). Plenty of margin below
    the ~95C panic, so run full speed. MCU temp/clock stay on the debug line
    as an early-warning. Revert to 150000000L if engine-bay soak proves hot.
2026-06-14 Raise exhaust brake kp 0.5 -> 2.0 (fix sluggish engagement)
    On-truck log showed the brake jumping toward OPEN on engage then crawling
    closed (e.g. TIP 35.6 -> Dem 76% = 88 - 0.5*24.4). Root cause: kp=0.5 is
    too small for the 0..VANE_OPEN(88) range — proportional could only command
    ~1/3 of the closure, so it leaned on the slow integral. kp=2.0 spans the
    full travel and slams closed on engage; integral trims to the 60psi target.
    Tune on truck. (Also confirmed in that log: brake now builds real
    backpressure ~27psi post-vane-cleaning, and MCU only ~54C at 600MHz.)
2026-06-15 Add BPR=1.0 boost control design spec
    Replace the open-loop boost->vane lookup map with a closed-loop PI
    controller targeting a backpressure ratio of 1.0 (drive pressure == boost).
    Mirrors the exhaust brake PI; fixed spool position below a boost threshold
    with bumpless handoff; no boost cap (deliberate, documented).
2026-06-15 Add BPR=1.0 boost control logic with native tests
    Pure PI controller targeting BPR (drive/boost) = 1.0, with a fixed spool
    position below a boost threshold and bumpless handoff into the PI. Mirrors
    exhaustBrakeLogic; native Unity tests cover spool, direction, gradient,
    handoff, and anti-windup. Wires the module into the native test build.
2026-06-15 Switch BoostController to BPR=1.0 closed loop (remove lookup map)
    BoostController is now thin glue: reads boost (COP-CIP) and drive pressure
    (TIP) from appData and calls boostBprStep. Removes the open-loop pressure
    lookup map and interpolation. Arbitration in ovgt.cpp is unchanged.
2026-06-15 Add boost-mode compile-time hedge + live BPR tuning
    BOOST_USE_BPR in boostController.cpp switches between the BPR PI loop (1) and
    the restored legacy lookup map (0) as a fallback; the unused path is #if'd out.
    Serial commands tune the BPR loop live without reflashing: `bpr <v>`, `kp <v>`,
    `ki <v>`, and `params` to print mode/values. The debug line now shows measured
    and target BPR as BPR:<measured>/<target>.
2026-06-15 Harden BPR boost loop: hysteresis, anti-windup, bake validated gains
    On-truck validation showed the loop locks BPR=1.00 at sustained cruise. Three
    refinements from the road data:
    - Bake kp=20/ki=20 as defaults (kp=88 was bang-bang; 20 glides). Still
    live-tunable over serial.
    - Hysteresis on the spool/PI boundary (boostSpoolPsi 1.5 / boostPiPsi 3.0)
    replaces the single boostMinPsi threshold, killing vane chatter when boost
    hovers at the boundary.
    - Actuator-tracking anti-windup: the integral only accumulates while the
    actuator has reached the last command (within integralTrackingBand). Stops
    the light-cruise windup that dumped a drive-pressure spike (BPR->2.0) on the
    next tip-in.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
2026-06-15 Revert actuator-tracking anti-windup (caused low-RPM power loss)
    On-truck the tracking-gated integral starved the closing action: the actuator
    slews continuously during normal driving, so |commanded - reported| was almost
    always over the band, freezing the integral. The vane ran ~15-20% too open at
    moderate load -> less drive pressure/boost -> lost low-RPM power.
    Back to the plain [0, travel] integral clamp that locked BPR=1.00 and made good
    power. Removes actuatorReportedPercent / integralTrackingBand / lastVanePercent.
    Keeps the hysteresis spool/PI dead band and baked kp=20/ki=20. The tip-in spike
    the gate targeted is the lesser evil; revisit with a gentler scheme later.
    Native 32 green;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
2026-06-16 Add COT sensor + compressor-efficiency (CE) telemetry
    - Enable CotSensor (MAX31856 K-type thermocouple, CS37); add COT to the
    1 Hz debug line. Verified on-truck (polarity + scaling).
    - New compressorEfficiency() pure module + native tests: isentropic
    efficiency e = Ti*(Pr^0.286 - 1)/(To - Ti) in Kelvin, shown as `CE:`.
    Computes whenever BR (Po/Pi) > 1.0, else `--`. Trustworthy only at
    sustained boost (COT heat-soak/lag biases it at idle/transients).
    - Reject faulted thermocouple samples in CotSensor and TitSensor
    (hold last-good) so an open/over-range TC can't poison COT/TIT/CE.
    Native: 37 tests green. Teensy builds.
2026-06-16 Add CE-accuracy design spec (float temps + cotSettle core)
    Software-only CE accuracy: float CIT/COT resolution + a pure slope-detection
    module (cotSettle) driving two outputs — a CE "settled" trust-flag (`~` marker)
    and an in-firmware probe time-constant (tau) + settling-time measurement that
    uses boost-settle as a fast reference to isolate probe lag. Faster-probe swap
    (B1 exposed TC / B2 thermistor) documented as the follow-on.
2026-06-17 Add CE-accuracy implementation plan
    3 tasks: float CIT/COT resolution; cotSettle pure module (settled-flag + tau)
    with native tests; wire into telemetry (CE ~ marker + COT settle report line).
2026-06-17 Store CIT/COT as float (sub-degree resolution for CE)
    CE divides by (COT-CIT); whole-degree storage was the noise floor. Fields ->
    float, sensor writes drop the int cast, debug prints %.1f. j1939 doesn't TX
    these, control loops don't read them.
    [AppData.h, adcSensors.cpp, ovgt.cpp]
2026-06-17 Add cotSettle: CE settled-flag + probe tau measurement
    Pure, native-tested. Tracks COT/boost slope; emits a sustained-flat 'settled'
    flag for CE trust, and (arming on boost-settle as a fast reference) measures the
    COT settling time + 63% time constant after each clean step. Tests cover the
    flag, tau extraction from a synthetic first-order step, and the abort paths.
2026-06-17 Wire cotSettle into telemetry: CE ~ marker + COT settle report
    CotSensor::update() now returns whether it wrote a fresh sample; the loop feeds
    cotSettle at the COT conversion rate. CE prints a trailing ~ when unsettled
    (transient/untrustworthy), and each clean tip-in->cruise prints a
    'COT settle: tau=.. t_settle=.. dT=..' line for probe characterization.
2026-06-20 Add MongoDB telemetry spec + firmware implementation plan
    Design spec: 10Hz NDJSON over serial via a reusable C-Next Json builder
    scope, a TS OpenTUI host that logs to MongoDB + sends tuning commands, and
    the ovgt.{telemetry,settle_events,sessions} schema. Firmware-first plan with
    the Json builder verified (transpile/compile/run). Part 2 (TS host) plan
    follows once the firmware emits.
2026-06-21 Add heap-free NDJSON builder (C-Next Json scope) for telemetry
    Reusable Json scope writes JSON into a fixed string<640> buffer via
    byte-writes only — no heap, no snprintf, MISRA-clean and deterministic.
    Supports uint/int/bool/string/2-decimal-float fields with automatic
    comma separation and overflow tracking.
    Generated json.c/json.h (cnext --header-out include) carry extern "C"
    guards so the Teensy C++ build can call Json_*. Unity test exercises
    every field type, zero and zero-padded floats, and a 21-field
    worst-case telemetry object that must fit the buffer without overflow.
    First module of the MongoDB telemetry firmware plan
    (docs/plans/2026-06-19-mongodb-telemetry-firmware-plan.md, Ta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
2026-06-21 Expose gate slopes and settle timer in CotSettleResult
    The COT slope, boost slope, and settled-flag accumulator are computed
    each step inside cotSettleStep but were not returned. Surface them as
    cotSlopeCperS / boostSlopePsiPerS / settleTimerS so the 10 Hz telemetry
    object can carry the gate's raw inputs, letting the host replay and
    re-tune the ~ settled-CE gate offline.
2026-06-21 Emit 10 Hz NDJSON telemetry + settle events (replaces pretty line)
    Replace the 1 Hz human-readable debug line with 10 Hz NDJSON built by
    the Json scope, so the host tool (Part 2) can log to MongoDB and replay
    the settled-CE gate. Two record types share the Json singleton buffer
    (sequential in loop(), no reentrancy):
    - "t" telemetry @ 10 Hz: pressures, boost/BR/BPR, temps, CE, demand/
    position, brake — gated by the 100 Hz loop counter (count % 10), so
    the IntervalTimer + volatile debugFlag + handleDebugTimer are gone.
    - "s" settle event on each gate measurement: tau/settle/step plus the
    newly surfaced COT slope, boost slope, and settle timer for offline
    gate validation.
    cnext_buil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
    [cnext_build.py, ovgt.cpp, ovgt.h]
2026-06-21 feat(telemetry-host): MongoStore (sessions + telemetry + settle inserts)
2026-06-21 feat(telemetry-host): orchestrator (serial/replay -> Ink + Mongo)
    Headless --replay loader awaits inserts; live path starts the serial
    source after mount so the Root feed subscription is live. Typecheck
    clean; 23/23 unit tests green. Live truck-verify is the on-vehicle step.
2026-06-22 docs(ce): real-time CE accuracy epic (sensor time-alignment + faster probe)
    Captures the two-lever plan to move CE from settle-point-only to real-time:
    Phase 1 aligns the two fast movers (COP<->COT) in software (offline-first,
    since CE is display-only), Phase 2 shrinks COT tau with a faster probe.
2026-06-23 docs(ce): establish CE-maximization north star + rework epic
    Document the project's objective function — control VGT vanes to maximize
    compressor efficiency — as an enduring north star (docs/north-star.md),
    anchored at the top of CLAUDE.md so it frames every CE/sensor/control step.
    Rework the real-time-CE epic from multi-agent research + adversarial review:
    - restore CIP/CIT as vital for accuracy/diagnostics (2nd-order only for timing)
    - add Phase 0 (dependable sensor time-drift measurement) and Phase 3 (control)
    - correct the offline-first sequencing (re-instrumentation is a hard gate;
    existing logs are EMA-filtered + 10Hz-decimated, unusable for alignment)
    - map-FF+PI primary / ESC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
2026-06-23 fix(cotSettle): windowed flatness so CE settled flag actually sets
    The CE 'settled' trust flag never set (0/854 on the 2026-06-19 drive, 0/13394
    on drive-2). Root-caused offline against logged data: the limiter is COT
    slope, not boost (the prior hypothesis). The flatness test computed COT slope
    on adjacent ~10 Hz samples, so the K-type's ~+/-0.08 C per-sample white noise
    became +/-0.4-1.5 C/s -- above the 0.3 C/s threshold ~50% of idle samples --
    and any single out-of-band sample hard-resets the 2 s timer, so it never
    completes (peaked at 1.45 s).
    Fix: compute the settled-flag flatness slope as a least-squares fit over a
    trailing window (slopeWindowSeconds=0.5 s) instead of adjacent samples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
    [cotSettle.cpp, cotSettle.h, ovgt.cpp]
2026-06-23 docs(ce): Phase 0/1 timing-alignment design (tau calculator + bench + delay buffer)
    Concrete design for measuring per-sensor lag and time-aligning CE's four
    inputs (delay_i = tau_max - tau_i, trigger per frame, interpolated delay
    lines). Adversarially reviewed (math/feasibility/completeness); folded in:
    - correct telemetry fields cop_hpa/cip_hpa (absolute), not cop_psi/cip_psi;
    BR = cop_hpa/cip_hpa absolute ratio (matches firmware)
    - tau fit in engineering units, reject truncated/non-first-order steps (no
    fallback tau=elapsed)
    - marker record needs host plumbing too (types/parse/store), not just firmware
    - post-de-EMA COP tau must be burst-measured, not assumed ~0 (it is the pair
    that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
2026-06-24 docs(ce): rename tau -> responseTime in alignment design (spell names out)
    Per preference: identifiers read as plain English, no abbreviations even for
    standard symbols. responseTime.ts / fitFirstOrderResponseTime / SensorResponseTime.
2026-06-30 tune(boost): default BPR target 1.0 -> 1.5 for on-truck comparison
    Driven a few hundred miles at BPR=1.0; bumping the power-on default to
    1.5 so the truck can be flashed and driven for a comparable stretch
    without laptop tuning while driving commercially. Runtime-tunable via
    `bpr <value>` as before.
2026-07-01 diag(boost): log controller region + integral to diagnose low-load stick
    At BPR target 1.5 the boost 'sticks' below ~4-5 psi at cruise then snaps
    to 25 psi. Suspected cause: BPR (= drive/boost) leads during tip-in, so a
    BPR-targeting loop OPENS the vanes exactly when spool wants them closed,
    suppressing boost until the rotor overtakes and the integral winds up.
    Expose the two hidden controller variables that distinguish the
    hypotheses and emit them in 10 Hz telemetry (flows into MongoDB):
    - boost_region: spool vs pi branch
    - boost_integ: integral windup that precedes the snap
    Telemetry-only; control law unchanged. Confirm the mechanism from a real
    drive log before touching the control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
    [ovgt.cpp]
2026-07-01 docs(logger): J1939 truck data logger design (iteration 1: raw capture)
    Passive Pi 5 appliance that losslessly captures every raw J1939 frame,
    stores forever on-device (MongoDB time-series on NVMe), queried over WiFi
    when parked. Raw-only this iteration; decode-to-named-signals deferred.
    Power/reliability (ignition-sense graceful shutdown) is a first-class
    requirement. Data-rate/storage sized: ~0.5-1.5 GB/driving-day, 2 TB ~=
    3-10 years.
2026-07-01 docs(logger): finalize power path — Mean Well DC-DC + SCap supercap UPS
    Two-stage discrete power chain replaces the generic 'power HAT' placeholder:
    - Stage 1: Mean Well wide-input DC-DC (9-36V in, 5V/6A) + input TVS —
    converts dirty truck 12V to clean 5V, shields Stage 2 from transients.
    - Stage 2: SCap supercapacitor UPS (5V pass-through + 15-110s hold-up,
    power-loss GPIO) — rides out key-off so MongoDB/NVMe close cleanly.
    - Shutdown: SCap power-loss pin -> Pi gpio-shutdown overlay.
    Captures why a DC-DC alone is insufficient (no hold-up -> corruption risk)
    and why cab install de-risks supercap temperature.
2026-07-01 fix(boost): spool-protect clamp kills the low-load handoff open-kick
    Root-caused from truck logs (region+integ diagnostics): at the spool->PI
    handoff, drive pressure leads boost so BPR (= drive/boost) reads transiently
    huge, and the PI proportional term flung the vane wide open (25 -> ~76),
    collapsing drive and stalling the spool — the low-load boost 'stick', then
    snap. The bumpless handoff only seeds the integral, not the proportional kick.
    Fix: below spoolProtectBoostPsi (default 6.0, tunable) the PI may still CLOSE
    the vane (add drive) but may not OPEN it past the spool position. Releases
    once boost is high enough that BPR is trustworthy (BPR ~ target by then).
    TDD: added test_spool_p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
2026-07-01 feat(telemetry): log + display Teensy on-die (MCU) temperature
    Firmware emits mcu_c from tempmonGetTemp() at 10Hz; host types it, renders it
    on the temp line (CIT/COT/TIT/MCU), and stores it (passthrough to Mongo).
    Teensy runs warm in the cab (~83C observed) so worth watching under load.
    TDD: format.test asserts 'MCU 45.3C'; host suite 24/24, typecheck clean.
2026-07-01 fix(telemetry): auto-recover the serial link across USB drops
    Vibration in the truck intermittently disconnects the Teensy's USB CDC
    (kernel logs clean disconnect + re-enumerate; firmware keeps running, J1939
    unaffected). The host tool used to die on it: open() threw ENOENT with no
    retry ('cannot open /dev/ttyACM0'), and the 'error' event never reconnected.
    Now connect() catches open() failures and retries, reconnects on 'error' as
    well as 'close', and de-dupes scheduling — a USB blip becomes a ~2s log gap
    that self-heals instead of a dead session. TDD: +2 serial tests, suite 26/26.
2026-07-01 feat(j1939): transmit turbo data on standard SPNs/PGNs
    Adds standard-SPN transmit so off-the-shelf J1939 tooling decodes our data
    with no custom DBC (see docs/j1939-spn-mapping.md):
    PGN 65170 SPN 1209 turbine inlet (exhaust) pressure (100 ms)
    PGN 65190 SPN 1127 turbo 1 boost pressure (500 ms)
    PGN 65176 SPN 1180 turbine intake temp (1 s)
    PGN 65178 SPN 1172 compressor intake temp (CIT) (1 s)
    PGN 64979 SPN 2629 compressor outlet temp (COT) (1 s)
    PGN 65177 SPN 1176 compressor intake pressure (CIP) (1 s)
    New j1939Encode module (pure, TDD'd): temperature (0.03125 C/bit, -273),
    boost (0.125 kPa/bit), turbo pressure (1/128 kPa/bit,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
2026-07-02 fix(boost): clamp runtime tuning inputs to sane ranges
    A dropped object mashed the serial 'bpr' key and loaded bpr_target=-6.65, which
    in auto mode would invert the loop and fling the vane. Clamp at the setters:
    bprTarget -> [1.0, 2.5], kp/ki -> [0, 200], so no stray/garbage command can ever
    load a dangerous value. TDD: clampBprTarget / clampGain unit tested.
2026-07-02 feat(telemetry): confirm manual-vane entry so stray keys cannot flip modes
    Entering a manual vane now stages the value and requires 'y' to confirm; ANY
    other key cancels. A dropped object mashing the keyboard can only ever cancel,
    never flip the truck into fixed-vane manual mode by accident. TDD: +2 app tests.
2026-07-02 fix(boost): floor PI vane demand at spoolPercent (bound the limit cycle)
    High-load limit cycle was slamming the vane 0<->55 stop-to-stop. Floor the PI
    demand at spoolPercent (the SAME variable as the spool-hold position) so the
    swing is bounded to [spoolPercent, vaneOpenCapPercent] (e.g. 22<->55), never
    fully closed. One variable drives both the spool hold and this floor. Folds the
    open cap into the same clamp. TDD: +test_vane_floored_at_spool_position.
2026-07-02 feat(telemetry): serial stall watchdog recovers from silent USB stalls
    A stalled Teensy CDC (bytes stop, no close/error event) used to hang the link
    until a physical replug. Add an inactivity watchdog: if no line arrives for
    stallTimeoutMs, tear down the fd (release cdc_acm), detach, and reconnect.
    TDD: reconnect-on-stall + no-reconnect-while-flowing tests.
2026-07-02 fix(telemetry): handle live Mongo write failures without crash or flood
    Live-path inserts were fire-and-forget with no .catch: a rejected write
    became an unhandled promise rejection, and any error handling would fire
    once per 10 Hz sample (log flood during an outage).
    Add recordTelemetry/recordSettle fire-and-forget wrappers that catch and
    report write health edge-triggered via onWriteError — one message when
    writes start failing, one when they recover. The awaited insert* methods
    are unchanged so the deterministic replay path still surfaces errors.
2026-07-02 refactor: remove ALL runtime config-over-serial (tuning is compile-time only)
    Live serial config is a driving hazard (a dropped object mid-drive mashed
    bpr_target to -6.65 and flipped to manual). Delete it entirely:
    Firmware:
    - remove ovgt::handleSerial (bpr/kp/ki/auto/params/manual-vane commands) + its call
    - remove manualMode/manualPwm (was a temporary hack; if ever needed it's a
    separate throwaway sketch, not baked in) — brake now always gets false
    - remove BoostController set{BprTarget,Kp,Ki}/printParams and the now-dead
    clampBprTarget/clampGain guards
    - tuning (bprTarget/kp/ki/spool/...) stays as compile-time constants: edit + flash
    Host TUI:
    - keymap down to l (label) / q (quit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
    [ovgt.cpp, ovgt.h]
2026-07-02 docs: spec systemHealth.cnx reset-cause capture + watchdog (Phase 1)
    Design for making every Teensy reset self-documenting in MongoDB and
    adding on-chip watchdog auto-recovery, motivated by the 2026-07-02 twin
    reboots (79C and 57.5C, both at idle -> not thermal; likely brownout or
    firmware hang). Routes existing-but-unlogged signals (CrashReport,
    PG_PIN, DWT loop timing) into the telemetry stream and adds a boot
    record + WDOG1 watchdog. Strictly additive, no control changes.
2026-07-02 docs: revise systemHealth spec — Phase 1 firmware-only, loop-timing profiling
    Verified host pipeline: store.ts spreads the sample (new "t" fields
    auto-store), but parse.ts drops unknown type values, so a separate
    type:"boot" record would be lost. Phase 1 therefore carries reset info
    as fields on the "t" record; the dedicated boot record + full crash text
    + TUI move to Phase 2 (host tool). Add loop_us_max/loop_us_avg + setup_ms
    so the 2s watchdog timeout can be right-sized from data.
2026-07-02 docs: implementation plan for systemHealth reset-cause + watchdog (Phase 1)
    Six TDD tasks: pure-logic C-Next module (reset-cause decode, loop-timing,
    Vin math; native-tested), hardware C-Next module (SRC/WDOG1 registers via
    ADR-004 register construct, GPR9 boot counter, watchdog), ovgt.cpp wiring
    (8 telemetry fields + watchdog feed), on-hardware verification. Includes
    smoke-tests for the two first-use C-Next features (register construct and
    cross-scope calls) with upstream-fix / fallback paths.
2026-07-03 docs(plan): J1939 full-bus logging implementation plan
    16-task TDD plan: pure decoders + health/online state machine (native
    Unity tests) -> SA-filtered ISR wiring + unknown-PGN inventory -> JSON
    buffer bump -> 10Hz value fields + 1Hz d/u diagnostic lines -> host
    parse/store into j1939_diag + j1939_unknown -> on-truck smoke drive.
    Reconcile spec to the flat message encoding the builder requires.
2026-07-03 feat(health): reset-cause SRSR decode (C-Next pure logic, native-tested)
    Task 1 of systemHealth Phase 1. Pure C-Next module decoding the IMXRT
    SRC_SRSR reset-status register to a stable cause code. Native Unity tests
    cover each bit + wdog-over-por precedence.
    Unblocked by the upstream c-next fix (scalar-param bit-indexing now emits
    shift-mask, not a pointer deref); transpiled with the fixed cnext.
    [cnext_build.py]
2026-07-03 feat(j1939): decode EEC1 RPM + driver-demand/actual torque
2026-07-03 feat(j1939): decode IC1 intake-air temp/boost + AMB pre-turbo pressure
2026-07-03 feat(j1939): decode ET1 coolant/oil temp + EFL-P1 oil pressure
2026-07-03 feat(j1939): decode VEP1 system/battery voltage (SPN 168)
2026-07-03 feat(j1939): decode ETC1 output/input shaft speed + clutch slip
    Byte offsets verified against j1939 DB (SPN 191 pos 2-3, 522 pos 4,
    161 pos 6-7) and oct receiver (SPN 191).
    [j1939Decode.cpp, j1939Decode.h]
2026-07-03 feat(j1939): decode ETC2 selected/current gear + gear ratio
    Byte offsets verified against j1939 DB (SPN 524 pos 1, 526 pos 2-3, 523 pos 4).
2026-07-03 feat(j1939): SA-filtered decode of engine+trans PGNs, online latch, unknown-PGN inventory
    Wires the tested decoders into j1939Sniff (SA 0x00 engine / 0x03 trans),
    stamps per-PGN lastSeen + domain-online latches, tallies undecoded PGNs.
    NOTE: compile-unverified in this environment (cnext binary unavailable to
    run the Teensy build); pure-logic deps are all native-tested.
2026-07-03 feat(health): loop-timing max/avg accumulator (native-tested)
    Adds loopTimingReset/Record/Max/Avg to SystemHealthLogic to track
    inter-feed loop interval max and mean since last reset, TDD'd with
    native Unity tests.
2026-07-03 feat(host): store J1939 diag + unknown-PGN docs in dedicated collections
    insertJ1939Diag/Unknown + record* fire-and-forget, indexes on
    {sessionId,t_ms}, wired into replay + live dispatch. vitest + typecheck green.
2026-07-03 feat(telemetry): add decoded J1939 signals to 10Hz line (null when not ok)
    Adds Json_addNull; emits 19 engine+trans signals gated by 5-state health
    (value when ok, JSON null otherwise) so analysis can trust non-null values.
2026-07-03 feat(telemetry): 1Hz J1939 diagnostic line (health + online flags)
    Emits type:d with engine/trans online flags, came-online uptimes, 15
    per-signal health states, and unknown-PGN counts.
2026-07-03 feat(health): systemHealth.cnx hardware module (SRSR, WDOG1, boot counter, Vin)
    First use of the C-Next register construct and cross-scope calls in this
    repo; both transpiled cleanly (validated via a throwaway smoke test, since
    deleted). systemHealth.cnx reads/clears IMXRT SRC_SRSR, increments the
    SRC_GPR9 boot counter, drives WDOG1, and samples Vin, delegating all math
    to the pure SystemHealthLogic module from Tasks 1-3.
2026-07-03 feat(health): emit reset-cause/boot/pg/vin/loop-timing + feed watchdog in ovgt loop
    [ovgt.cpp]
2026-07-03 fix(health): move OVGT_VIN_ADC_PIN off pin 40 (CIT CS conflict) -> pin 20 (A6)
    Final holistic review caught that pin 40 is the CIT MAX31856 chip-select
    (citSensor.cpp CS_PIN=40), driven OUTPUT-HIGH every boot by the SPI CS-init
    loop in ovgt.cpp — so analogRead(40) would read a driven digital pin, and
    wiring a 12V divider there would clash with the CIT sensor. No live impact
    (OVGT_VIN_ENABLED=0), but corrected before any physical divider is wired.
    Pin 20 (A6) verified free against the current pin map.
    [SystemHealthConfig.h]
2026-07-05 feat(telemetry): emit + display actuator motor load & temp
    Surface actuatorMotorLoad (act_load) and actuatorTemp (act_temp) in the 10Hz
    NDJSON line and on the host actuator display. act_load is the actuator's motor
    effort (0=coasting, ~2220=straining) — a live gauge of the vane fighting
    exhaust backpressure, verified on the bench self-test. Host fields are optional
    (absent in pre-2026-07-05 logs) so replay of older sessions still parses.
2026-07-05 test(actuator): parked bench self-test sketch + env
    actuator_selftest.cpp sweeps vane demand 0<->88 with no backpressure and
    watches CAN feedback, reusing the real Actuator scope (same CAN3/cmd mapping).
    Separate [env:actuator_test] so the teensy41 firmware is untouched; teensy41
    filter excludes the test main. Confirmed on-truck: closes fully unloaded (pos 1
    @ demand 0), so the on-road float-open under load is backpressure vs actuator
    torque. Reflash real fw: pio run -e teensy41 -t upload.
2026-07-05 feat(boost): clamp PI vane demand to boost-scheduled open cap
2026-07-05 feat(telemetry): show vane_cap on host actuator line
2026-07-06 fix(telemetry): select serial by USB serial-id, fail closed (never wrong board)
    pickTeensyPort now matches a specific USB serial and returns the stable
    /dev/serial/by-id symlink, never a bare /dev/ttyACM*. Defaults to the OVGT turbo
    controller running-serial 11969470 (override --serial/OVGT_SERIAL); refuses to
    connect if that board is absent instead of grabbing the first 16c0 device (which
    could be the vulCAN logger 16550620). NOTE: a Teensy reports a different serial in
    HalfKay bootloader (00124393) vs running firmware (11969470).
2026-07-07 docs(j1939): MCU-health frame design spec (PGN 0xFFDC, per-SA fleet health)
    Proprietary B PGN 65500/0xFFDC broadcast at 1 Hz so every Teensy MCU
    (OVGT/OSSM/OCT) reports MCU die temp + reset cause + boot count + uptime,
    collectable by source address. Canonical codec ships in jlaustill/J1939
    on main (v2), ahead of the v3 rewrite.
2026-07-07 docs(spec): vane-cap on-truck validation status + corrected physics
    Road-tested 2026-07-05→06: stall gone (act_load 599 vs 2220), BPR on target
    through a 27 psi pull, pos tracks cap. Corrected premise: backpressure ASSISTS
    vane closing; the earlier 'stall' was a loose turbo, now fixed. Open item:
    sustained loaded-trailer pull + EGT watch. Merge-ready pending that.
2026-07-07 docs(j1939): OVGT MCU-health frame adoption plan (subsystem 2)
2026-07-07 feat(telemetry): buildMcuHealth() maps controller health to McuHealth
    Adopt jlaustill/J1939 (2.1.0); pure host-tested helper maps MCU temp +
    reset cause + boot count + uptime into the library McuHealth struct with
    sentinel-safe u16 capping (0xFFFE, never the 0xFFFF N/A sentinel).
    [mcuHealthFrame.cpp, mcuHealthFrame.h]
2026-07-07 feat(telemetry): broadcast MCU-health frame (PGN 0xFFDC) at 1 Hz
    Populate McuHealth from tempmonGetTemp + SystemHealth reset-cause/boot-count
    + uptime minutes, encode via jlaustill/J1939, send on CAN2 as 0x18FFDC01
    from the existing transmit1000ms() cadence.
    [j1939.cpp]
2026-07-07 docs(j1939): fix mcuHealthFrame.cpp self-include in adoption plan
    teensy41 build uses -I include (not -I src), so the .cpp must include its
    own header same-dir as "mcuHealthFrame.h". Caught during execution.
2026-07-07 tune(boost): lower spool vane hold 22% -> 18% for more aggressive spool
    Re-test of a previously-reverted value (18 spiked EGT 2026-07-02) to chase
    the recurring low-boost underboost CEL/defuel. spoolPercent is shared across
    the spool hold, sub-6psi protection clamp, and PI floor, so all three close
    4% harder. Watching TIT (EGT proxy) on-truck.
2026-07-07 feat(telemetry): broadcast OVGT's own oil pressure + temp sensors
    Emit the ADS2 oil sensors (150 PSI ratiometric -> oil_press_psi, AEM 30-2013
    thermistor -> oil_temp_c) that were being read into appData but never sent.
    Distinct from the engine ECU's J1939 oil_c/oil_kpa. Host TUI renders them to
    the right of CE% to watch turbo oil feed under load.
2026-07-09 docs(cot): design spec — RIFE Hi-AT thermistor replaces COT thermocouple
    Swaps the slow K-type COT probe (τ≈5-6s) for a fast RIFE Hi-AT NTC on the
    never-used ADS2 ch3 (ex fuel/lift-pump). 1.0kΩ pull-up, Steinhart-Hart
    conversion (0.11°C fit), raw passthrough, cotSettle fed at native ADS rate
    with resized buffers. Phase 2 of the CE accuracy epic.
2026-07-09 docs(cot): implementation plan — RIFE Hi-AT thermistor COT swap
    4 TDD tasks: pure cotThermistor module, cotSettle buffer resize, ADS2 ch3
    decode w/ raw passthrough + fresh flag, and remove the MAX31856 thermocouple.
2026-07-09 feat(cot): pure RIFE Hi-AT thermistor voltage->C conversion module
2026-07-09 feat(cot): size cotSettle buffers for the ~200 Hz ADS feed
2026-07-09 feat(cot): read RIFE COT thermistor on ADS2 ch3, raw + fresh flag
2026-07-09 feat(cot): drive cotSettle from ADS COT, remove MAX31856 thermocouple
    Feed cotSettle from AdcSensors::cotSampleReady() instead of the deleted
    MAX31856 CotSensor; drop its CS pin 37 from the SPI-init loop.
    Kept vs. the plan (both shared, not orphaned):
    - liftPumpPressureHpa: still broadcast as J1939 SPN 94 (PGN 65263); the
    channel was never wired so it was already always 0 — unchanged.
    - Adafruit MAX31856 lib: still used by titSensor (active) and tot/citSensor.
2026-07-24 docs(turbo): Holset H1-frame reference + 12cm housing build notes
    Research notes covering the HX35/HX40/HY35/H1C interchange pool: the shared
    H1 bearing housing, unique factory configurations, what actually swaps
    (and what only appears to), aftermarket parts, and the cm2-vs-A/R caveat.
    Records the current build: 70/60 turbine in a divided T3 12cm wastegated
    housing with turbine-side actuator. 3532214 verified across multiple
    vendors; 3591217T is an unverified repro (absent from both public Holset
    PN references, non-Holset "T" suffix) but worth the gamble at 1/5 the
    price. Includes the measurement checklist still owed.
2026-07-24 docs(turbo): resolve DPS adapter mounting + drop long-housing concern
    DPS adapter replaces the 5-bolt flange directly and reuses the same
    gasket; it does not clamp to the V-band. Long-housing outlet position is
    moot since everything is currently positioned around an S300 DPS
    Turbonator and needs fitment adjustment regardless.
    Checklist narrows to: blade count, inducer, hot pipe size, inlet flange
    holes, casting verification, and photographing the wastegate actuator
    boss on arrival.
2026-07-24 docs(turbo): cores are HY35W not HX35 — breaks the 12cm housing plan
    Inspection found HY35W cores, which are a different turbine-wheel family:
    65.5/58 curved on a 9cm undivided housing, vs the 70/60 straight wheel
    the 12cm divided housing is bored for. Bolts up, oversized tip gap,
    doesn't work.
    No rebuild path either: AVP's 70/60 wheel & shaft (3519336) lists
    HX35/HX35W/H1C/WH1C and explicitly excludes the HY35W. Records the real
    boundary on the "H1 frame all interchanges" rule — CHRA family is shared,
    HY35W turbine rotating assembly is not.
    Adds three options with the recommendation to source an HX35/H1C core:
    the HY35W's 54mm compressor on 9cm is likely undersized for the ~400hp /
    45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
2026-07-24 docs(turbo): add core identification procedure
    Holset service PNs are 7 digits; the riveted data tag (compressor outlet
    or bearing housing pad) carries model + PN + serial, and is the
    authority. Casting numbers only confirm frame family.
    Records the two unidentified markings on the HY35W cover: 8654-PP reads
    as a die-cast mold number, 2028600067 as a supplier lot number in a
    format common on reproduction covers — worth noting since a swapped
    cover is how a core gets misremembered.
    Notes that model ID isn't the real decision here: turbine exducer
    (58 vs 60mm) and housing (undivided 9cm vs divided 12cm) settle it.
    HY35W ID corroborated by provenance ('01 automatic).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
2026-07-24 docs(turbo): frame-size intuition + housings bore out, never in
    Records the DPS turbine sizes (S362 = 78mm, S363 = 80mm, both above the
    generic S300 numbers) against the HY35W's 65.5mm, with the D^2 flow /
    D^5 inertia scaling that explains why the size gap feels so much larger
    than it looks.
    Adds the machining asymmetry to the interchange table: a housing can be
    bored out for a bigger wheel (done in practice on the Turbonator housing
    for the S363's 80mm wheel) but never filled in for a smaller one — which
    is why the HY35W mismatch has no lathe fix. Notes in-house lathe access
    so machining options aren't theoretical.
2026-07-24 docs(turbo): test plan for the stock-spec HX35 baseline
    Records the configuration under test (56mm comp / 70mm turbine / divided
    12cm) and why stock spec is the right baseline: best-documented point in
    the catalog, so deviations are interpretable.
    Pre-registers the bigger-vs-smaller decision criteria before any data is
    collected. Wastegate behavior is the primary signal since it isolates the
    turbine from the compressor; BPR/CE/TIT/spool are supporting. Actual
    thresholds left as TODO — those are judgment calls, not defaults.
    Flags baseline validity: take it only on a known-sealed turbo, per the
    loose-turbo lesson (drive-pressure leak mimics undersizing). Notes the
    ~4000ft pressure-ratio o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
2026-07-24 docs(turbo): Stage 8 fasteners retire the loose-turbo caveat
    Turbo now runs Stage 8 locking fasteners on studs — mechanical retaining
    clip, not friction — so fastener rotation is no longer a viable
    drive-pressure leak path. That was the exact prior failure (turbine bolt
    walked out).
    Downgrades the baseline-validity warning accordingly and lists what's
    actually left if underboost reappears: crushed gasket, warped flange, or
    stretched stud, none of which involve a nut turning.
2026-07-25 docs(turbo): second core confirmed HX35W (3592766) — build is on
    PN 3592766 verified across multiple vendors as genuine Holset HX35W
    (HX35W-E7755M/E12PY11, '99-02 Dodge 6BT/ISB 5.9L). Turbine is 70/60 12-bl
    in a 12cm T3 twin-entry housing — exactly what the 3591217T housing is
    bored for, so the 12cm plan proceeds on this core.
    Leaves one open question: this is the 7-blade compressor and vendor
    listings for this PN say 54/77 against the 56mm build target. Records the
    54-vs-56 dispute as genuinely unresolved (Mopar1973Man says 56/76.5) and
    adds calipering it to the checklist.
    CHRA marking 353052 doesn't resolve — 6 digits vs Holset's 7. Not
    load-bearing; the assembly PN identifies the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
2026-07-25 docs(turbo): resolve CHRA number 3530521 (faint last digit)
    3530521 is the bearing housing (82mm OD), catalogued under both HX35 and
    HX40 assemblies — HX35W gensets, HX40M, 6CT HX40W, 1993 6BT. Direct
    in-hand corroboration of the shared-H1-frame claim the document rests on,
    now cited up front alongside the HY35W exception.
    The 3592766 core is fully consistent and genuine: HX35W assembly on the
    common 3530521 center section.
2026-07-25 docs(turbo): compressor measures 54mm — settles the 54-vs-56 dispute
    Measured in hand: PN 3592766's 7-blade compressor is 54mm, matching the
    vendor listings and contradicting Mopar1973Man's 56/76.5. A caliper
    outranks the forum tables; noted as such.
    Two consequences recorded. First, the outgoing HY35W carries the same
    54mm compressor, so this becomes a clean hot-side-only experiment
    (turbine 58->60 exducer, housing 9cm undivided -> 12cm divided) with no
    compressor confound — better hygiene than the intended 56mm.
    Second, flow margin is tighter than estimated: ~45-50 lb/min against a
    ~45-50 lb/min target means operating at the ceiling. If CE falls off at
    peak flow the compressor is the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
2026-07-25 docs(turbo): odd-blade caliper correction; 54mm is nominal, not measured
    The 7-blade wheel reads 52-54mm tip-to-tip, but odd blade counts have no
    diametrically opposed tips, so calipers span a chord: measured = D *
    cos(90/N), which for N=7 is 0.9749. A true 54mm wheel reads 52.6mm, and
    a 52mm reading back-solves to 53.3mm — so the low readings are consistent
    with 54mm nominal, not evidence against it.
    Adds the correction table (7/9/11 blades), notes even-blade wheels
    measure true, and gives the easier method: caliper the cover's inducer
    bore and subtract tip clearance.
    Also flags that uncorrected tip-to-tip readings may be the source of some
    of the 54-vs-56 confusion in the published tab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
2026-07-25 docs(turbo): fix the odd-blade caliper correction — 54mm not yet settled
    The previous factor (x1.0257) modeled point contact on two blade tips.
    Flat caliper jaws actually bridge two tips while resting on one, giving
    M = R(1 + cos(180/N)) — verified against the known 3-flute rule that an
    end mill measures 75% of diameter across flutes. For 7 blades the
    correction is x1.0521, not x1.0257.
    Consequence: the 52-54mm tip-to-tip readings correct to 54.7-56.8mm,
    straddling both candidate specs, so the measurement does NOT settle
    54 vs 56. Reverts the "resolved" claim to a working assumption based on
    the vendor listings, with a cover-bore measurement pending.
    Also notes this as the likely sourc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
2026-07-25 docs(turbo): HX35W is the compound HP stage — reframes the flow analysis
    Corrects a wrong conclusion: earlier revisions sized the 54mm compressor
    as a standalone turbo and called it "at the flow ceiling." It's the HP
    stage fed by the S472, so corrected flow (m * sqrt(T/Tref) / (P/Pref))
    roughly halves at ~2:1 inlet pressure, netting ~1.8x more actual mass
    flow after the temperature term. ~45-50 lb/min as a single becomes
    ~80-90 lb/min as an HP stage — comfortable against a 45-50 lb/min
    requirement, and the billet 60-62mm upgrade path is likely moot.
    Compressor confirmed 54mm from the Holset specs; calipering could never
    have settled it. Records that this HX35W is a no-cost stand-in for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
2026-07-25 docs(turbo): HP gate is the only boost control — S472 LP is ungated
    Records that the HX35W's internal wastegate is the sole boost control on
    the truck, and the mechanic that matters for setting the spring: on a
    compound the HP gate dumps into the LP turbine inlet rather than to
    atmosphere, so bypassed energy is handed to the S472. The spring sets the
    split between stages, making handoff rpm and peak boost a single coupled
    adjustment rather than two knobs.
    Adds the too-stiff / too-soft failure modes and notes the HX35W brings HP
    overspeed protection the planned ungated BorgWarner would not have had.
2026-07-25 docs(turbo): HP gate is a backpressure limiter, not a boost limiter
    Corrects yesterday's framing. The HP gate dumps into the LP turbine
    inlet, so bypassed gas keeps its energy: opening it drops HP PR but
    raises LP PR, and total boost is the product of the two, so they largely
    cancel. It has little boost authority compared to a single-turbo gate.
    What it actually controls is drive pressure — the HP turbine is the
    restriction, and routing around it lowers backpressure while the energy
    still gets used downstream.
    Which makes the spring a mechanical BPR limiter, and BPR is already the
    control variable (PI target 1.5) — giving a real design criterion for
    preload rather than guesswork. Also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
2026-07-25 docs(turbo): it's a spring gate — no actuator, no boost reference
    The build deletes the stock boost-referenced canister for the "instant
    spool spring mod": a spring holds the flapper shut and exhaust
    backpressure on the flapper area is the only opening force. Confirmed as
    established compound practice — spring wastegates on the secondary turbo
    referenced to drive pressure rather than boost.
    This structurally settles why the gate can't limit boost: boost is not an
    input to it. Drops the now-void actuator plumbing question.
    Adds two usable facts: sizing is a force balance (cracking pressure =
    F_spring / A_flapper, so preload is calculable from flapper area and
    target drive pressure), and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
2026-07-26 docs(turbo): accept the missing speed sensor; record the retrofit findings
    Turbo speed was dash-display only and never a control input to OVGT, so
    the H1 frame's lack of a speed-sensor boss costs nothing functional.
    Overspeed stays inferred from CE drop + COT rise at constant BR.
    Records why the "adapt an HE351VE cover" idea doesn't work: the Holset
    sensor is a variable reluctance pickup targeting a ground flat on the
    shaft, not a compressor-cover blade counter. Retrofit would need a
    bearing-housing boss, a shaft flat, and VSR rebalancing — the balancer
    is the blocker, not the machining.
    Notes the BW S257 as the next-step candidate if the HX35 proves
    mis-sized, with a speed-sensor provis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
2026-07-26 docs(turbo): S257 is the "just right" upgrade, not the mis-size fallback
    Had this backwards. The S257 is near-identical in size to the HX35 (57mm
    vs 54mm compressor), so it isn't a re-size — it's the same turbo with a
    speed-sensor provision and modern wheels. It's what you buy if the HX35
    size is CONFIRMED correct. Adds the decision tree.
2026-09-12 docs(turbo): catalogue the 28 valid 70/60 turbine housing PNs
    Adds docs/holset/hx35/turbine-housings.md: every genuine Holset part
    number catalogued as a turbine housing for the 70/60 straight-wheel
    family (H1C/WH1C/HX35/HX35W/HX35M), with the lookup method that found
    them. Specs are sourced for exactly one (3521927, 16 cm non-gated);
    the rest are marked "?" rather than inferred.
    Two corrections to holset-turbos.md fall out of the lookup:
    - 4038909H is a COMPLETE TURBOCHARGER, not a bare housing. The catalog
    lists it as TURBOCHARGER,ID21,HX35 and the vendor page confirms a full
    assembly that *has* a 16 cm non-WG housing. It was mis-filed under
    "Turbine housings". The bare 16 cm housi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
    [jhdiesel-full-catalog.tsv]
2026-09-12 docs(turbo): specs for 3 more housings; 3532214 meets the gate requirement
    Requirement: 12 cm2, 70/60, divided, and either non-gated or a wastegate
    whose actuator is self-contained on the turbine housing — a spring gate on
    the currently-fitted housing fouls the compressor cover.
    3532214 matches outright. Its vendor text speaks to the exact problem:
    "Actuator is contained on the turbine side and does not need to bolt to
    compressor housing." The interference is generational — Holset moved the
    canister onto a compressor-cover bracket after the first-gen/WH1C era.
    Fills three of the 28 "?" rows from one vendor category page:
    - 3524123 — 12 cm, twin-entry divided, NON-gated, short housing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
2026-09-12 docs(turbo): withdraw the 3524123 outlet claim as overstated
    The note said the 3524123 outlet "appears not to be the 5-bolt flange."
    That was an impression, not a finding, and no verified image of the
    casting has been located — product photos don't qualify.
    What the sources actually support is a different claim: the long/short
    distinction is about outlet POSITION, not bolt pattern. Short outlet is a
    drop-in for 1988-1993 and reportedly needs the exhaust moved forward
    ~1.25" on 1994-1998. Forum sources also claim H1C and HX35 outlets share
    a 3-1/8" V-band clamp, which would make the outlet compatible but
    displaced — though other forum text calls the early H1C outlet a "hose
    connection".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
2026-09-12 docs(turbo): 3591217 found cast into a housing — verdict upgraded
    An eBay listing ("12CM 96-98 Ram 5.9 T3 HX35w WH1C twin scroll turbine
    exhaust housing 60mm") shows 3591217 and "12 L54" cast into the casting,
    described as 12cm twin scroll for the 60mm HX35 wheel, 96-98 style, with
    the wastegate actuator rod perpendicular to the inlet flange, 13 lbs 2 oz.
    This contradicts the basis of the UNVERIFIED verdict. That rested on an
    earlier listing described as "Unmarked ... 3591217" — no Holset number
    cast in. Casting numbers are molded into genuine Holset turbine,
    compressor and bearing housings, so a cast-in number is the opposite
    evidence. 3591217 now reads as a genuine Holset casting numb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
2026-09-12 docs(turbo): add compressor-housing and CHRA/core references
    Same treatment as turbine-housings.md, from the same archived
    cross-reference: 29 compressor housings and 67 core assemblies for the
    H1C/WH1C/HX35/HX35W/HX35G family.
    The compressor-housing doc answers the open requirement — a 56 mm cover
    without wastegate tabs — and the answer turns out to explain the original
    clearance problem:
    8-blade, 56/82-83, '95-98 12v -> canister mounts on the TURBINE housing
    -> cover has NO tabs
    7-blade, 54/77-78, '99-02 24v -> canister mounts on the COMPRESSOR cover
    -> cover HAS tabs
    So the tab-free cover is the 8-blade 56 mm o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
2026-09-12 docs(turbo): survey 56 mm cover + wheel sourcing, tab-free confirmed by photo
    The on-hand core is 7-blade 54 mm, so the 56 mm wheel and a cover must be
    bought together. Surveyed live listings 2026-09-12:
    - wheel only, $45-50 — seller states "fits 1996-1998 ... does not fit
    factory HX35 on 1999-2002 manual", independently confirming the
    generation rule
    - cover + 56 mm 8-blade wheel, $159.99 — tab-free
    - complete '96-98 turbo, ~$312-331 — also brings a 12 cm turbine housing
    with the turbine-side gate, i.e. solves both open problems at once;
    worth pricing against 3532214 alone at ~$599
    - "supercore" listings found are 52 mm, not 56 mm — wrong wheel
    Listing photos for the $159.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
2026-09-12 docs(turbo): correct the ~$312 complete-turbo option — it has a compressor-mounted gate
    Previously flagged as the value play on the reasoning that a '96-98 unit
    would carry the turbine-side gate and so deliver a tab-free cover. Photos
    of the actual listing (ebay.com/itm/357345678203, seller yikaparts, ships
    from CN) show the opposite: the wastegate canister rides on a long diagonal
    bracket bolted to the COMPRESSOR housing, rod running down to the arm on
    the turbine housing. That is the arrangement this requirement exists to
    avoid. The T3 gasket is correctly divided, but the actuator mounting is
    wrong for this build.
    The cited PNs 3539373 and 3538881 are both genuine TURBOCHARGER,HX35
    WAST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
2026-09-12 docs(turbo): DECISION — keep the 54 mm wheel, cut tabs off the existing cover
    Staying on the 7-blade 54x78 compressor already on core 3592766. The
    wastegate tabs get cut off that cover rather than buying a tab-free 56 mm
    cover and wheel for ~$160.
    The 52 vs 60 lb/min flow conflict can't be settled from available sources,
    but it can be settled from logged map coverage — the truck already carries
    10 Hz CE/BPR/boost telemetry. Buying the 56 mm first would mean spending on
    numbers this doc already flags as untrustworthy. Matches the "stock-spec
    baseline, then iterate" test plan in holset-turbos.md.
    Deferred, not abandoned: the swap is a cover-and-wheel pair whenever data
    justifies it, and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
2026-09-12 docs(turbo): record the turbine-sizing experiment and its confounds
    The objective is turbine-side sizing — is the 70/60 too small or correct
    for HP duty in the compound — judged from spool, EGT and backpressure. The
    54 mm compressor decision is therefore a held constant, not a compromise.
    Records three things that could otherwise invalidate the result:
    1. Confound. :264 already says a too-stiff spring causes "BPR climbing".
    So does an undersized wheel, and so does an undersized housing. High BPR
    alone cannot distinguish them.
    2. No gate position feedback. The build deletes the pneumatic canister for
    a pure spring gate (:267), so the decisive discriminator — gate already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
