jlaustill/ovgt/(notices)

Notices in the files:
README.md:
License: MIT
